juanalexismartinez557-a11y/Sistema_Autom-tico_de_Ventilaci-n/(list of files, drawings)

Other design files:
Evidencia de simulacion/Simulation.pdsprj
