juanalexismartinez557-a11y/Sistema_Autom-tico_de_Ventilaci-n/(commit log)

2026-07-31 Creacion de carpetas
2026-07-31 DOCS: añadi las datasheet de los materiales
2026-07-31 DOCS: se añadio el documento tecnico(incompleto) y el Diagrama de bloques
2026-08-10 Documento final de Proyecto de Ventilador
2026-08-10 Simulación de Sistema de Ventilacion
    Simulación Final de Circuito de Ventilación en base a sensor de temperatura.
    [Simulation.pdsprj]
2026-08-10 Video de Funcionalidad del Circuito
